christian-sanches/2d-led-matrix/hardware/pcb-v1/PROGRESS.md

# PCB Carrier V1 — progresso

- [x] Confirmar arquitetura: NodeMCU LoLin ESP8266 em sockets; módulos externos; carrier 70 × 90 mm.
- [x] Confirmar ligações do firmware, conector microSD, chicote da matriz e alimentação externa.
- [x] Instalar KiCad 10.0.7 e preparar o projeto KiCad.
- [x] Criar o primeiro esquemático elétrico da carrier.
- [x] Executar ERC do KiCad: 0 violações.
- [x] Posicionar footprints e fechar o contorno/layout de 70 × 90 mm.
- [x] Roteamento de sinais e alimentação da matriz, com plano de +5 V e plano de GND.
- [x] Executar DRC, corrigir violações e verificar a paridade esquemático↔PCB: 0 violações / 0 desconectados.
- [x] Exportar Gerbers e arquivos de furação em `fabrication/`.
- [ ] Revisar encaixe/clearance do NodeMCU, SD e conectores na visualização 1:1. **Etapa atual.**
- [x] Confirmar a tensão do módulo SD: 3,3 V (jumper do JP1 entre os pinos 1 e 2).
- [ ] Confirmar a posição dos quatro furos de fixação no perfboard atual.

> Ainda não enviar arquivos para fabricação até concluir a revisão 1:1 e as duas confirmações físicas acima.
