christian-sanches/2d-led-matrix/hardware/pcb-v1/drc-report.txt

** Drc report for 2d-led-matrix-carrier.kicad_pcb **
** Created on 2026-11-04T13:34:01 **
** Report includes: Errors, Warnings, Exclusions **

** Found 0 DRC violations **

** Found 0 unconnected pads **

** Found 0 Footprint errors **

** Ignored checks **
    - Footprint has no courtyard defined
    - Track endpoint not centered on via
    - Tuning profile track geometries
    - Footprint doesn't match symbol's footprint filters
    - PTH inside courtyard
    - NPTH inside courtyard

** End of Report **
