christian-sanches/2d-led-matrix/hardware/pcb-v1/erc-report.txt

ERC report (2026-11-04T13:20:16, Encoding UTF8)
Report includes: Errors, Warnings, Exclusions

***** Sheet /

 ** ERC messages: 0  Errors 0  Warnings 0

 ** Ignored checks:
    - Global label only appears once in the schematic
    - Four connection points are joined together
    - Assigned footprint doesn't match footprint filters
