christian-sanches/2d-led-matrix/hardware/pcb-v1/fabrication/drill-report.txt

Drill report for 2d-led-matrix-carrier.kicad_pcb
Created on 2026-11-04T13:35:00

Copper Layer Stackup:
    =============================================================
    L1 :  F.Cu                      front
    L2 :  B.Cu                      back

Drill file '2d-led-matrix-carrier.drl' contains
    plated through holes:
    =============================================================
    T1  0.300mm  0.0118"  (16 holes))
    T2  0.800mm  0.0315"  (2 holes))
    T3  1.000mm  0.0394"  (44 holes))
    T4  1.300mm  0.0512"  (5 holes))

    Total plated holes count 67

Not plated through holes are merged with plated holes
    unplated through holes:
    =============================================================
    T5  3.200mm  0.1260"  (4 holes))

    Total unplated holes count 4
