christian-sanches/2d-led-matrix/hardware/pcb-v1/previews/pcb-bottom.png

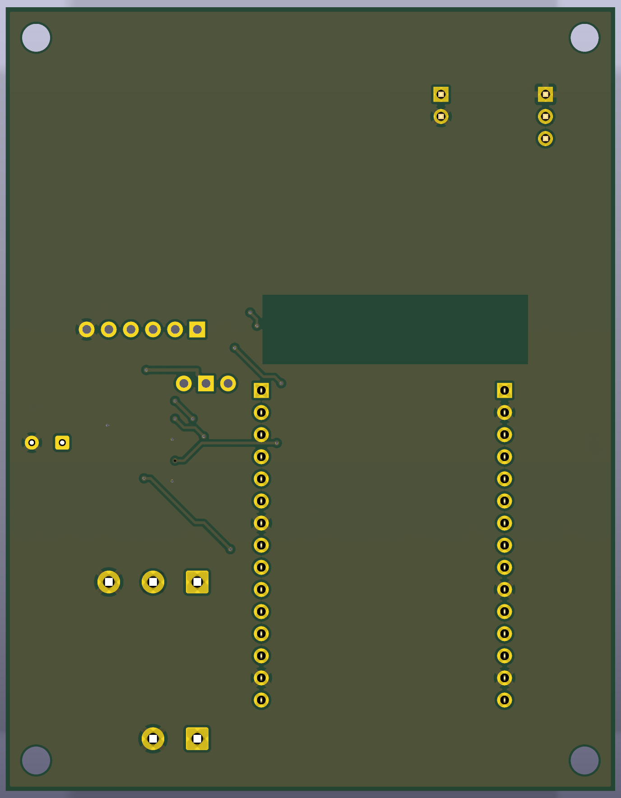
hardware/pcb-v1/previews/pcb-bottom.png
