christian-sanches/2d-led-matrix/hardware/pcb-v1/previews/pcb-top.png

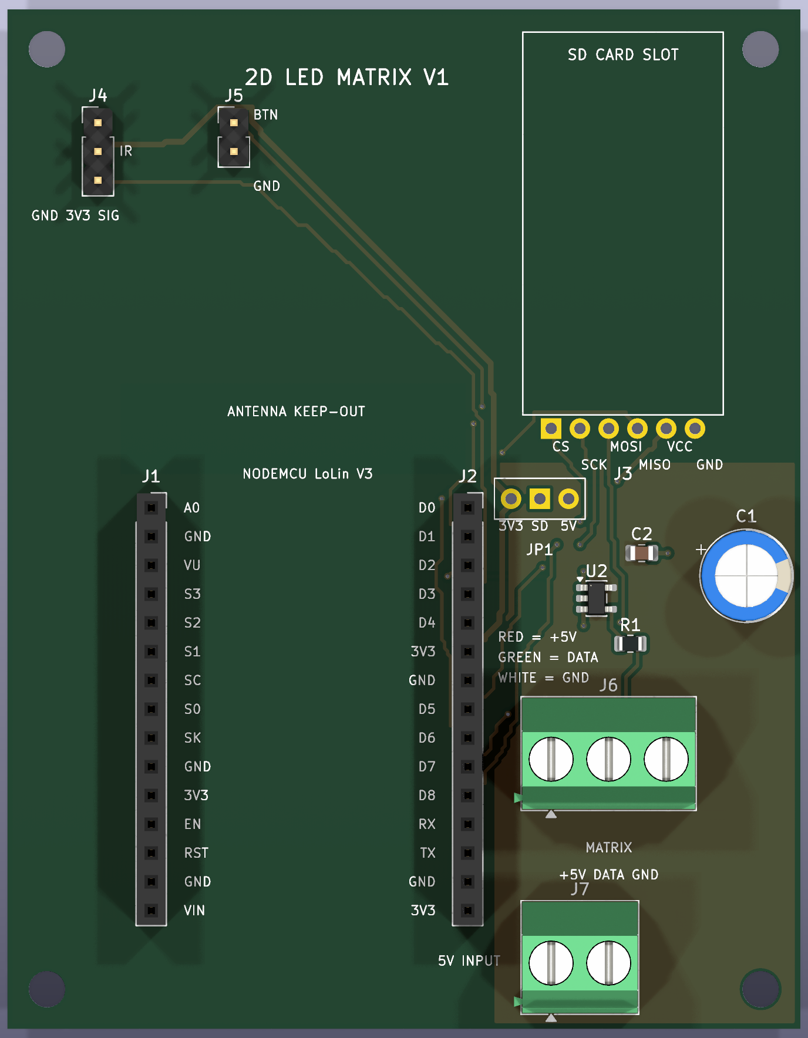
hardware/pcb-v1/previews/pcb-top.png
