christian-sanches/2d-led-matrix/hardware/pcb-v1/previews/2d-led-matrix-carrier.pdf

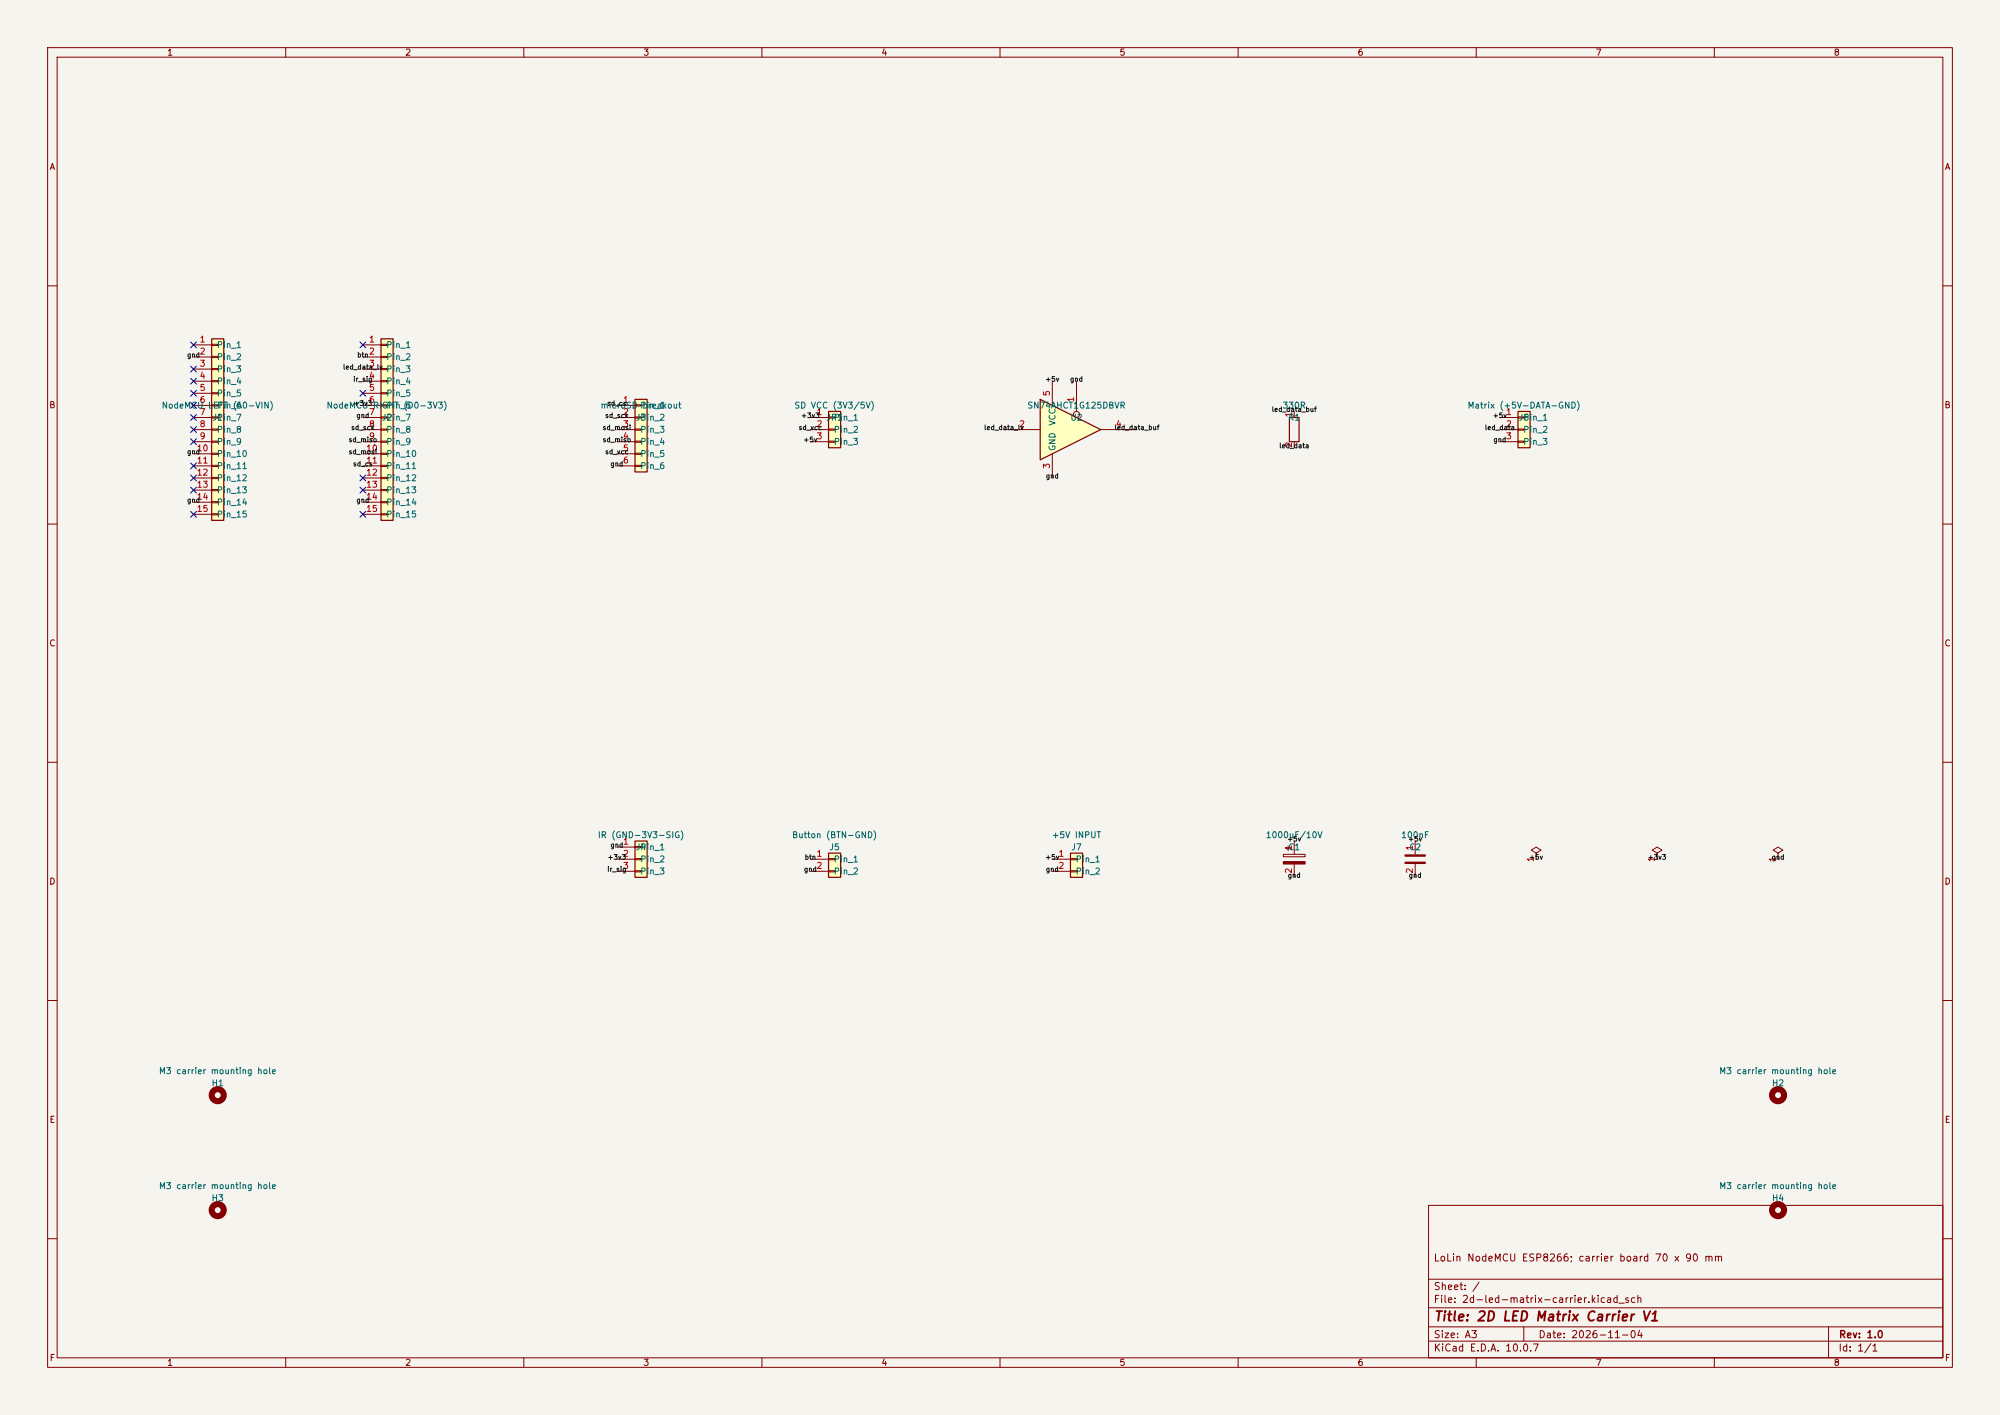
[picture p3: page 1]

IR (GND-3V3-SIG) H3 M3 carrier mounting hole

LoLin NodeMCU ESP8266; carrier board 70 x 90 mm

Sheet: /
File: 2d-led-matrix-carrier.kicad_sch
Title: 2D LED Matrix Carrier V1

Size: A3 | Rev: 1.0 | F Date: 2026-11-04
KiCad E.D.A. 10.0.7 | Id: 1/1
