christian-sanches/2d-led-matrix/hardware/pcb-v1/previews/pcb-1to1.pdf

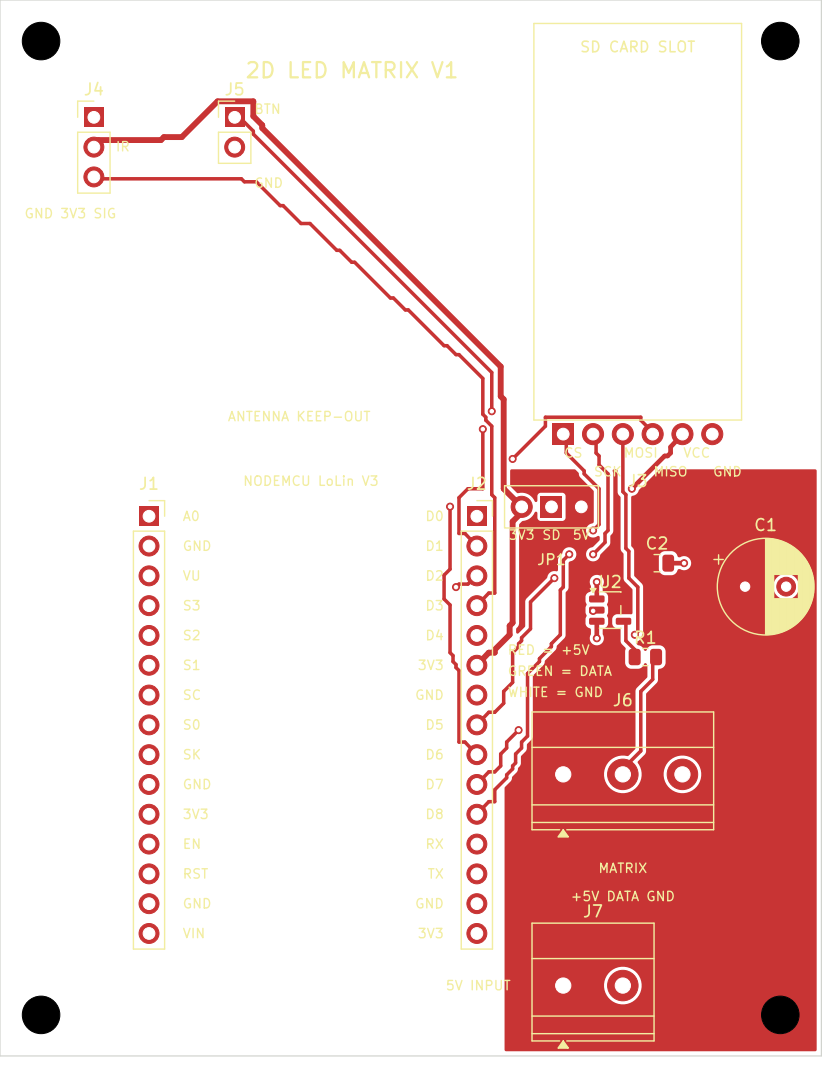
[picture p4: page 1]

SCK MOSI SD CARD SLOT MISO
5V INPUT 2D LED MATRIX V1 J4
