christian-sanches/2d-led-matrix/hardware/pcb-v1/2d-led-matrix-carrier.kicad_pcb

## KiCad design hardware/pcb-v1/2d-led-matrix-carrier.kicad_pcb (2026-11-04)

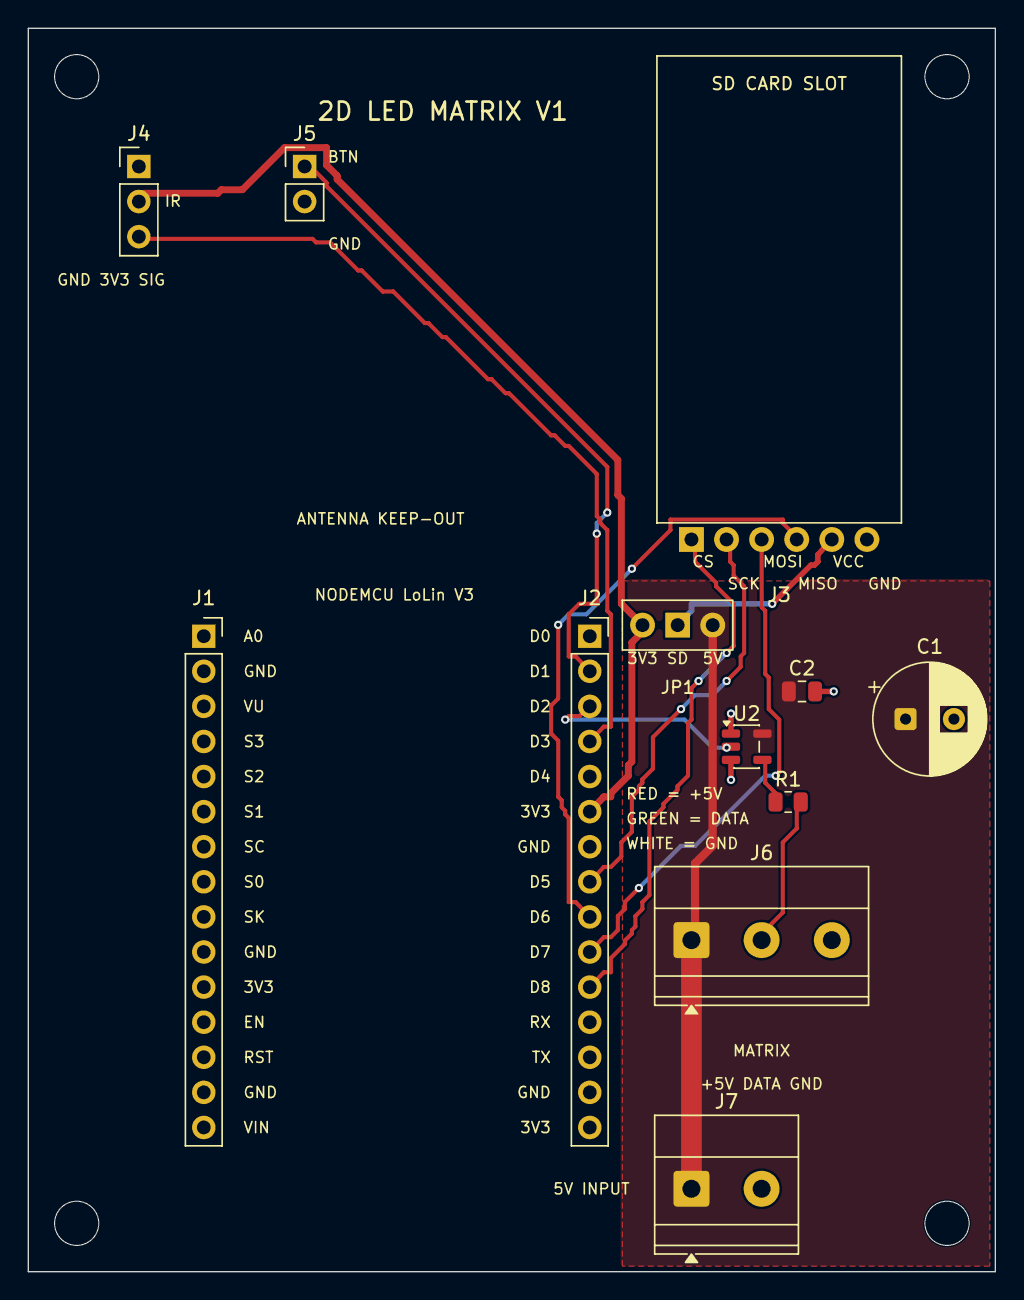
[picture p5: board 2d-led-matrix-carrier.kicad_pcb from above]

Board: 2 copper layers, 70.0 x 90.0 mm, 16 parts (0 on the bottom side), 13 nets.

Parts:
C1: 1000uF/10V; CP_Radial_D8.0mm_P3.50mm
C2: 100nF; C_0805_2012Metric
H1, H2, H3, H4: M3; MountingHole_3.2mm_M3
J1: NodeMCU LEFT (A0-VIN); PinSocket_1x15_P2.54mm_Vertical
J2: NodeMCU RIGHT (D0-3V3); PinSocket_1x15_P2.54mm_Vertical
J3: microSD breakout; SD_Module_1x06_P2.54mm
J4: IR (GND-3V3-SIG); PinHeader_1x03_P2.54mm_Vertical
J5: Button (BTN-GND); PinHeader_1x02_P2.54mm_Vertical
J6: Matrix (+5V-DATA-GND); TerminalBlock_Phoenix_MKDS-1,5-3-5.08_1x03_P5.08mm_Horizont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
J7: +5V INPUT; TerminalBlock_Phoenix_MKDS-1,5-2-5.08_1x02_P5.08mm_Horizont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
JP1: SD VCC (3V3/5V); SD_VCC_Selector_1x03_P2.54mm
R1: 330R; R_0805_2012Metric
U2: SN74AHCT1G125DBVR; SOT-23-5

Connections:
+3V3: J2.6, J4.2, JP1.1
+5V: C1.1, C2.1, J6.1, J7.1, JP1.3, U2.5
BTN: J2.2, J5.1
GND: C1.2, C2.2, J1.2, J1.10, J1.14, J2.7, J2.14, J3.6, J4.1, J5.2, J6.3, J7.2, U2.1, U2.3
IR_SIG: J2.4, J4.3
LED_DATA: J6.2, R1.2
LED_DATA_BUF: R1.1, U2.4
LED_DATA_LV: J2.3, U2.2
SD_CS: J2.11, J3.1
SD_MISO: J2.9, J3.4
SD_MOSI: J2.10, J3.3
SD_SCK: J2.8, J3.2
SD_VCC: J3.5, JP1.2
