christian-sanches/2d-led-matrix/(commit log)

2026-11-03 docs: add hardware diagrams and simulation files
    [2d-led-matrix.kicad_sch, kicad_schematic_project.kicad_sch]
2026-11-04 feat(web): add LED matrix preset studio
2026-11-04 feat: establish working ESP8266 matrix foundation
    [2d-led-matrix.kicad_sch]
2026-11-04 feat: add 8x8 Arduino menu module
2026-11-04 fix(menu): refresh timeout on application controls
    [MenuController.cpp, MenuController.h, main.cpp]
2026-11-04 fix(menu): scroll labels in reading order
    [MenuController.cpp, MenuController.h]
2026-11-04 fix(sim): discover SD library and esptool dependency
    [main.cpp]
2026-11-04 fix(sim): use RMT output for Wokwi matrix
    [DisplayController.h, main.cpp]
2026-11-04 fix(sim): improve menu navigation feedback
    [main.cpp]
2026-11-04 Add DRC-clean carrier PCB v1: schematic, layout, Gerbers and previews
    - 70x90 mm two-layer carrier for the LoLin NodeMCU ESP8266
    - ERC and DRC both report zero violations / zero unconnected pads
    - Gerbers and Excellon drill files in hardware/pcb-v1/fabrication
    - Rebuildable layout/router in build_pcb.py
    Generated-by: opencode
    [2d-led-matrix-carrier-B_Cu.gbl, 2d-led-matrix-carrier-B_Mask.gbs, 2d-led-matrix-carrier-B_Silkscreen.gbo, 2d-led-matrix-carrier-Edge_Cuts.gm1, 2d-led-matrix-carrier-F_Cu.gtl, 2d-led-matrix-carrier-F_Mask.gts, 2d-led-matrix-carrier-F_Silkscreen.gto, 2d-led-matrix-carrier-job.gbrjob]
2026-11-04 Add ready-to-upload Gerber archive
2026-11-04 docs: clarify power topology and set SD VCC to 3.3 V
2026-11-04 chore: refresh KiCad project settings for KiCad 10
